dan-sazonov/CanSAD/Лого.jpg

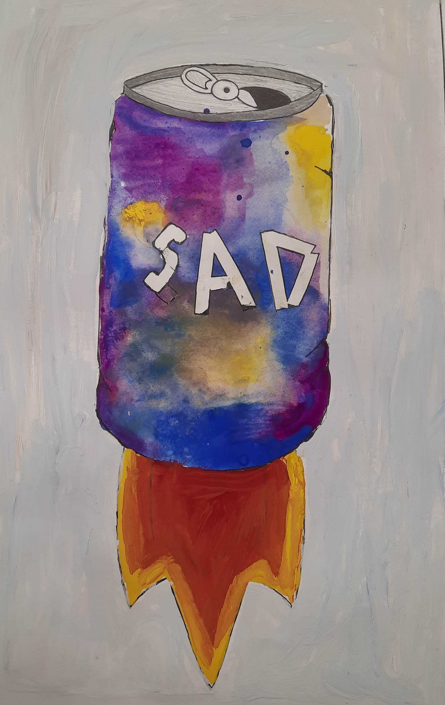
Лого.jpg
