dan-sazonov/CanSAD/Фотки сырые/СС сложенная чертеж.jpg

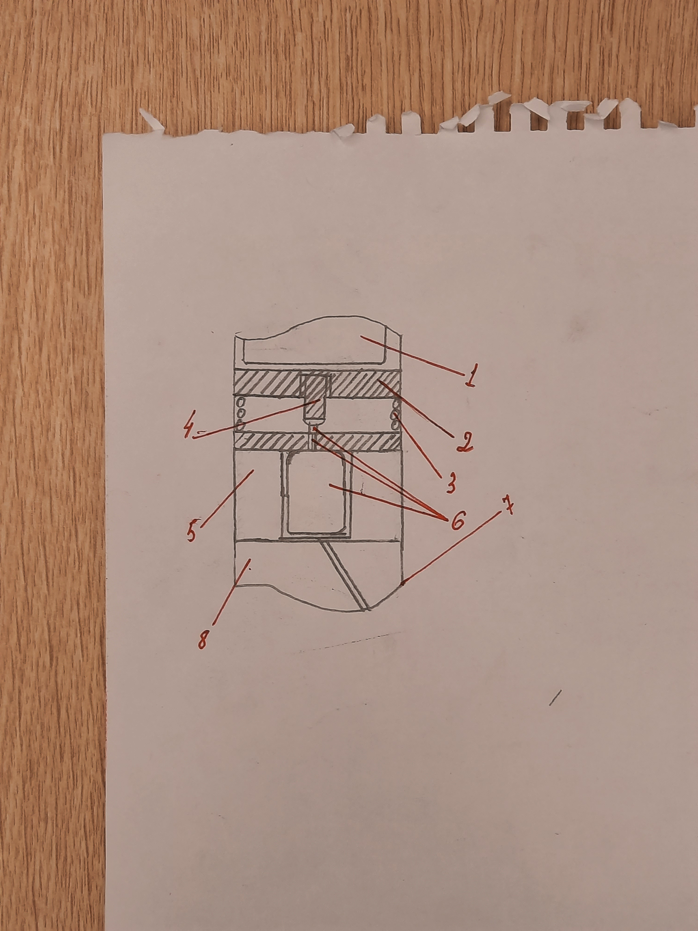
Фотки сырые/СС сложенная чертеж.jpg
