dan-sazonov/CanSAD/README.md

# 🚀CanSAD team
Все рабочие материалы, презентация и пояснительная записка победителей региональных соревнований по спутникостроению "Дежурный по планете".
