dan-sazonov/CanSAD/Доклад.md

# CanSAD

## 1. Обложка
На доске, мы выходим, Дэн приветствует всех

## 2. Состав команды
_Д:_ Наша команда состоит из программиста Даниила Сазонова, 17 лет<br>
_Л:_ и инженера Алексея Аукенова, 14 лет.

## 3. ТЗ
_Л:_  На этом слайде вы видите список задач, которые мы поставили перед собой и решили в ходе работы над данным проектом. При составлении этого списка мы отталкивались от 
информации, представленной в положении юниорской лиги кансата.

## 4. Алгоритм работы спутника
_Д:_ Это блок-схема алгоритма работы системы спасения. После разделения разгонного модуля и отсека полезной нагрузки, которое будет зафиксировано с помощью фоторезистора, микроконтроллер будет ожидать снижения до 110 метров, после чего будет запущен сервопривод, который активирует систему спасения и произойдет выброс парашюта. Значение в 110 метров было выбрано не случайно, на следующих слайдах будет приведено обоснование.

## 5. Фото системы спасения
_Д:_ На этом слайде вы видите фото системы спасения в разложенном виде. Отдельно можно отметить способ прикрепления парашюта. Этот демпфер должен погасить часть энергии во время рывка после открытия купола. К нему через вертлюг прицеплен парашют. Это сделано для того чтобы предотвратить повреждение и запутывания строп.

## 6. Система спасения в сборе
_Л:_ На этом чертеже представлена система спасения полезной нагрузки до срабатывания. Ее принцип работы состоит в том, что за две секунды до достижения высоты в 50 метров сервопривод начинает вращение, и откручивает с вала, на котором закрплен болт, гайку, которая фиксирует пружину с помощью крышки. Чтобы гайка не прокручивалась, было принято решение зафиксировать ее в пропечатанных пазах.

## 7. Система спасения после активации
_Л:_ После того, как гайка слетает с резьбы, пружина освобождается, толкает крышку и она выталкивает сложенный парашют на высоте в 50 метров. Так происходит выброс парашюта, который должен обеспечить плавное приземление отсека с полезной нагрузкой.

## 8. Пружина для системы спасения 
_Л:_ Здесь вы видите чертеж используемой в системе спасения пружины, и все необходимые данные. Исходные значения были измерены нами, все указанные на чертеже значения были получены при помощи онлайн калькулятора на сайте катээс-про

## 9. Расчет времени работы сервопривода
_Д:_ Как известно, сервопривод может поворачиваться только на определенный угол. Для SG90 это 180. Чтобы он мог вращаться сколько угодно, в его конструкцию были внесены некоторые изменения. Таким образом, его вал совершит полный оборот за 0.6 секунды. Чтобы открутить гайку достаточно сделать 3 оборота примерно за 2 секунды, но для предотвращения непредвиденных ситуаций время работы ограничено 5 секундами.

## 10. Расчет высоты активации системы
_Д:_ Чтобы знать на какой высоте нам необходимо активировать систему спасения, нам необходимо знать, на какой высоте будет находится спутник за 2 секунды до высоты в 50 метров. Для этого нам нужно узнать предельно возможную скорость свободного падения. Из 2зн следует, что сила сопротивления свободно падающего тела будет равна его весу. Выразить из этого неравенства скорость и найдём её значение. Важно понимать, что это не реальная скорость снижения, а максимально возможная, те мы берём это значение с довольно большим запасом. Дальше мы умножаем эту скорость на 2 секунды и прибавляет 50 метров, так мы находим высоту активации СС.

## 11. Парашют для СС
_Л:_ На этом слайде вы видите фотографию использанного парашюта, а также формулы для вычисления радиуса парашюта, который фигурирует в дальнейших расчетах. Формула для нахождения площади была взята из пособия Соболева, также как изначения констант. Значения массы спутника и скорости снижения были взяты из регламента соревнований 

## 12. Сегмет парашюта
_Л:_ На данном чертеже мы видим лекало, по которому вырезались сегменты шестисегментного купольного парашюта для спасения отсека с полезной нагрузкой. Данные значения и форма были получены опираясь на схемы и формулы из пособия Соболева, подробнее с ними вы можете ознакомиться в пояснительной записке. 

## 13. Расчет строп парашюта
_Д:_ Здесь представлены расчёты характеристик строп парашюта. Для начала найдем их длину. Согласно материалам из пособия Соболева, длина должна составлять 2.4 радиуса, или 36 см. Теперь найдём максимально возможную силу натяжения строп. Максимальной она будет в момент открытия купола. Подставим в данную формулу известные значения и вычислим силу натяжения. Возможно такое, нагрузка будет неравномерно распределена между шестью стропами, но учитывая что мы брали максимально возможную скорость, уже сделан достаточный запас. 

## 14. Плата спутника
_Л:_ Вот фотография платы нашего спутника. Все ключевые элементы отмечены на схеме, отдельно можно отметить джемперы для переключения вывода юарт. Когда они установлены, и контакты замкнуты, пакеты телеметрии передаются по протоколу юарт на радиомодуль, и он транслирует их по радиоканалу на приемную станцию. Когда они сняты, пакеты идут в монитор порта платы.

## 15. Структурная схема спутника
_Д:_ Это блок-схема электроники полезной нагрузки. Акселерометр, датчик давления, магнитометр и температурный датчик, которые представлены модулем GY801, подключаются к микроконтроллеру по протоколу I2C. Модуль SD карты использует интерфейс SPI, приемопередатчик – UART. Источником питания является литий-полимерный аккумулятор с напряжением 7,4В, который подключается к Arduino Nano. Остальные элементы, отраженные на приведенной ниже блок-схеме, питаются напряжением +5В, которое снимается со встроенного в Arduino Nano линейного стабилизатора.

## 16. Принципиальная электрическая схема
_Д:_ На этом слайде вы видите принципиальную схему полезной нагрузки. Для получения, обработки и передачи информации между модулями спутника используется мк ардуино нано на чипе атмега 328. Для отправки телеметрии на приемную станцию по радиоканалу на частоте 433 мегагерца используется приемопередатчик sv610. Также все данные записываются на эсдэ карту. Для измерения параметров среды используется модуль GY801. Для измерения напряжения аккумулятора используется резистивный делитель напряжения с коэффициентом деления 2. Пониженное напряжение подается на контакт A7. Для ограничения тока питания приемопередатчика SV610 используется транзистор VT2. Через транзистор VT1 подается напряжение на сервопривод системы спасения. 

## 17. Алгоритм работы спутника
_Л:_ На этом слайде представлена блок-схема алгоритма работы програмного кода полезной нагрузки. Микроконтроллер анализирует данные, полученные со всех датчиков. Выполняя расчеты, микроконтроллер фиксирует точки старта, апогея, посадки, разделения полезной нагрузки и разгонного модуля, запускает в нужный момент систему спасения и сохраняет и передает телеметрию. Технические моменты более подробно описаны в пояснительной записке и на слайде. 

## 18. Расчет энергопотребления
_Л:_ Здесь вы видите таблицу, в которой представлена информация о энергопотреблении всех элементов схемы. Мы рассматривали пиковые значения тока поребления. Также мы сделали запас и рассчитали ток потребления для одновременно восьми работающих светодиодов на протяжении всего времени полета, хотя в реальности такое не возможно.

ШОУ ИМПРОВИЗАЦИЯ
