dan-sazonov/CanSAD/Чертежи сырцы/СС общий вид.pdf

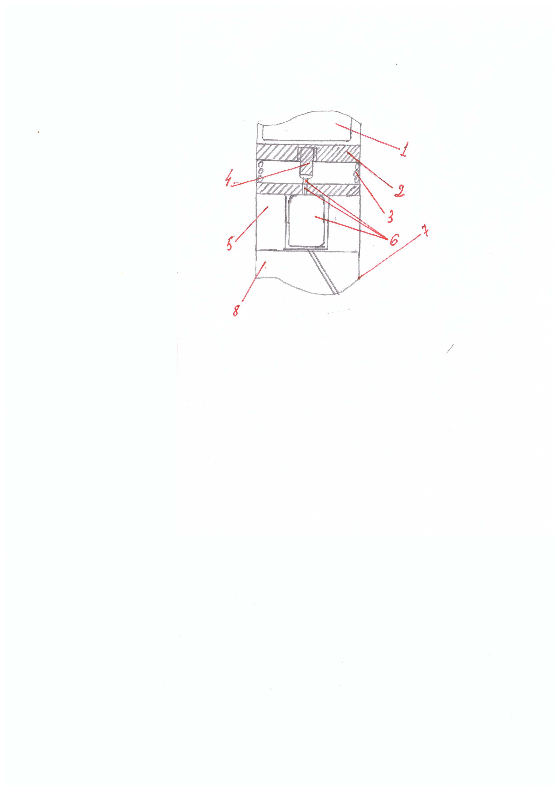
[picture p49: page 1]
