dan-sazonov/CanSAD/Чертежи сырцы/СС открытая.pdf

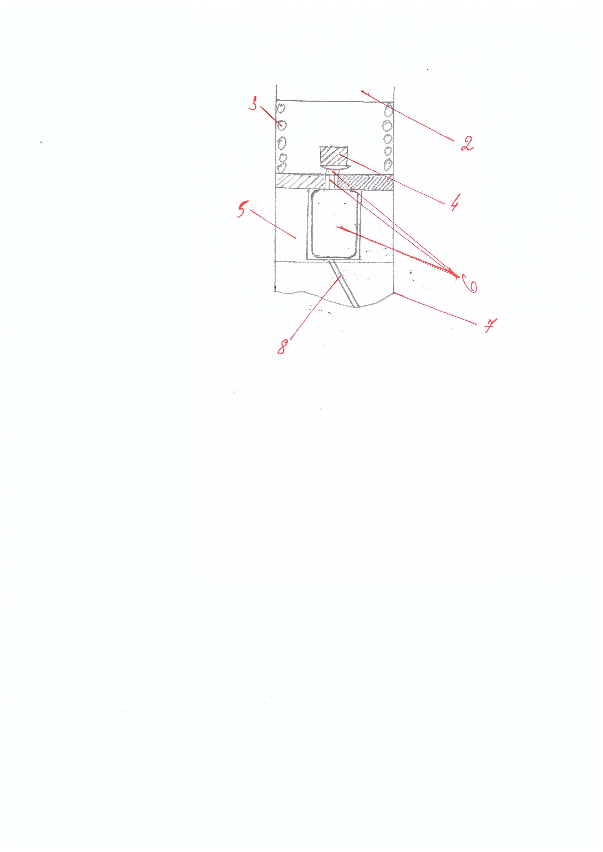
[picture p50: page 1]
