dan-sazonov/CanSAD/Фотки наши/Даня.jpg

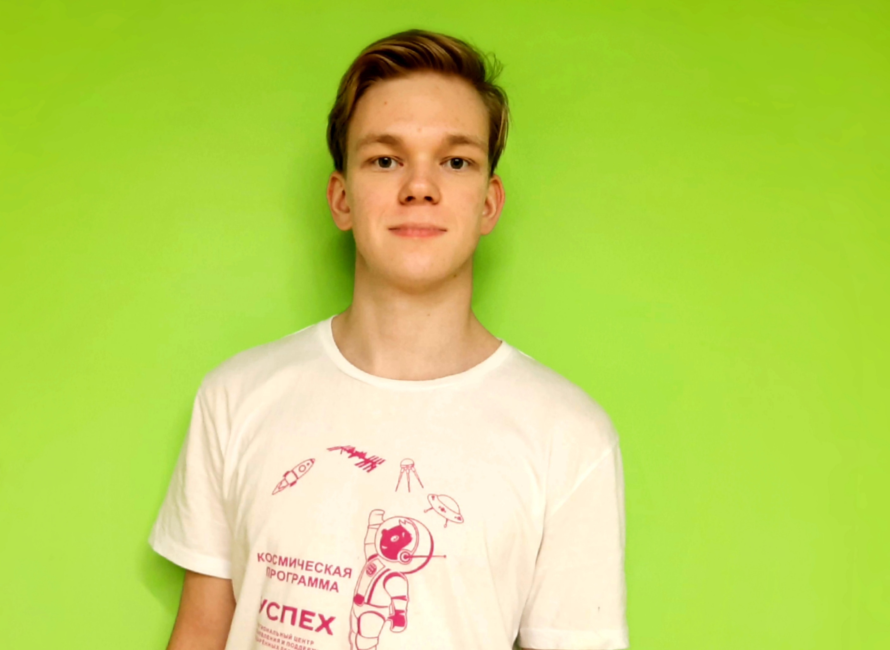
Фотки наши/Даня.jpg
