dan-sazonov/CanSAD/Фотки наши/Леха.jpg

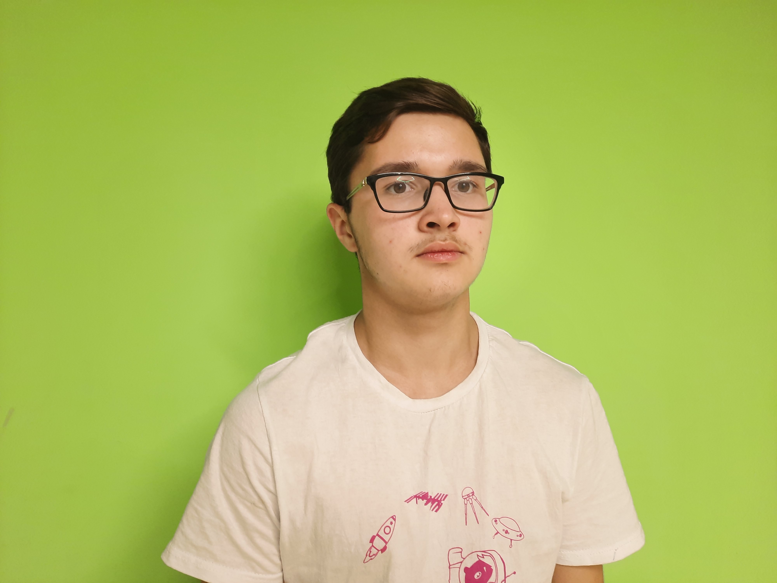
Фотки наши/Леха.jpg
