dan-sazonov/CanSAD/Фотки преза/Cерва фотка.jpg

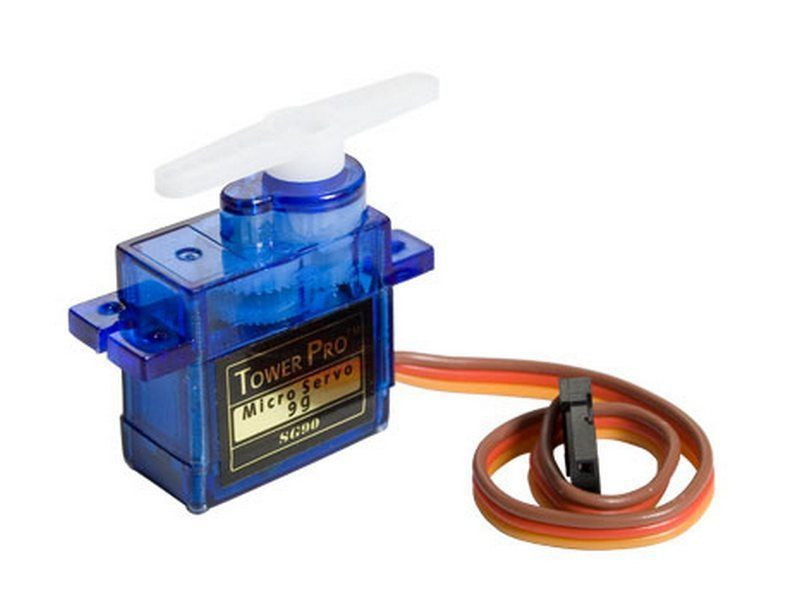
Фотки преза/Cерва фотка.jpg
