dan-sazonov/CanSAD/Фотки преза/Парашют.jpg

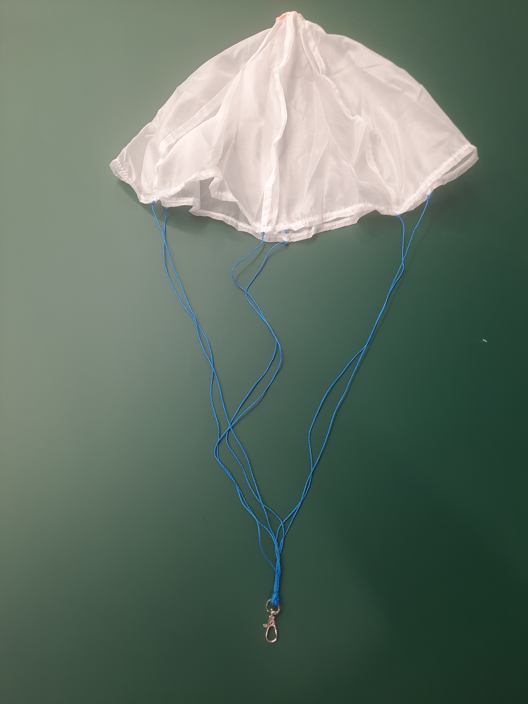
Фотки преза/Парашют.jpg
