dan-sazonov/CanSAD/Фотки преза/Спутник фотка.jpg

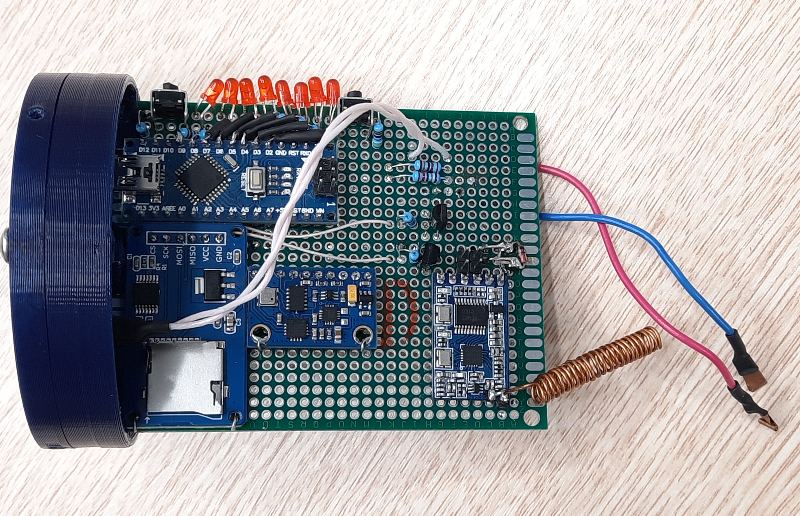
Фотки преза/Спутник фотка.jpg
