dan-sazonov/CanSAD/Фотки преза/СС общий вид.jpg

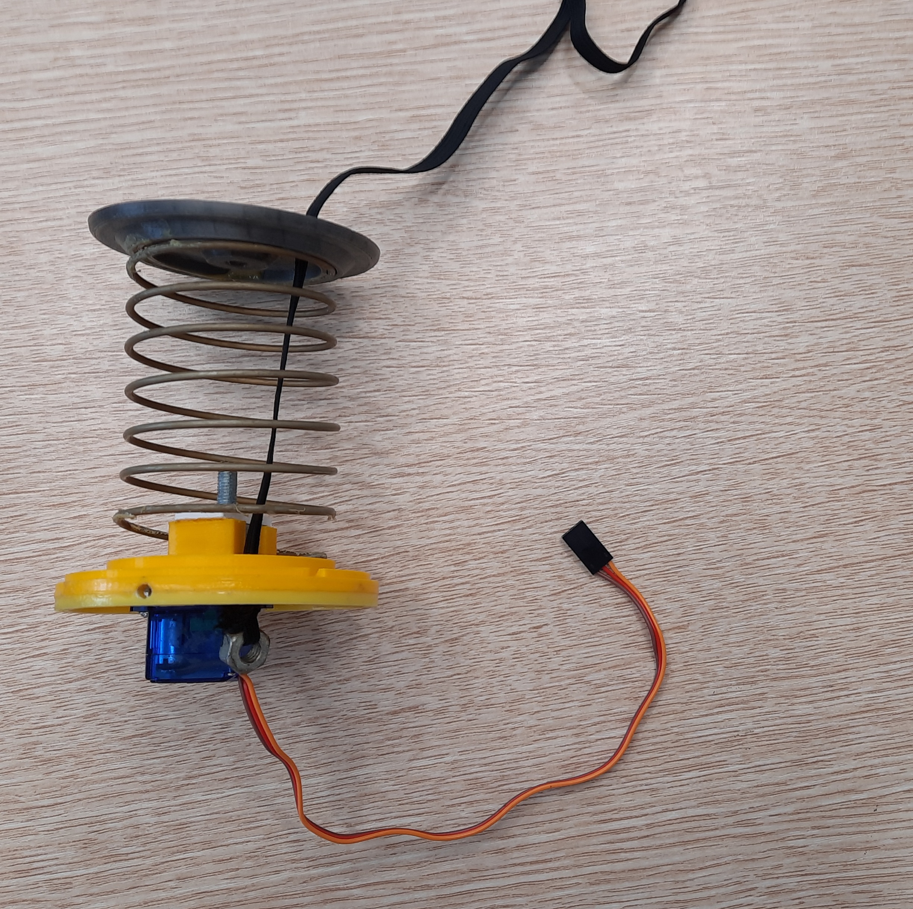
Фотки преза/СС общий вид.jpg
