dan-sazonov/CanSAD/Фотки сырые/СС общий вид чертеж.jpg

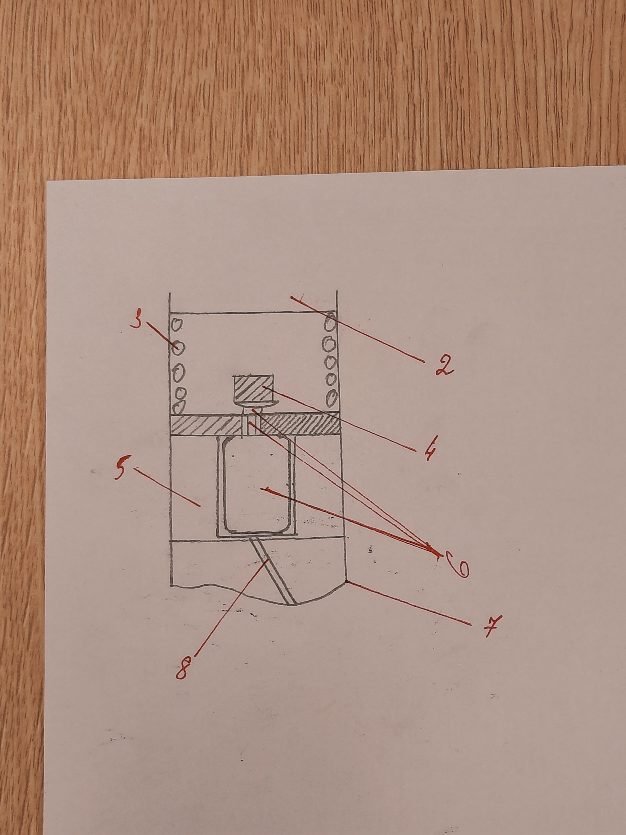
Фотки сырые/СС общий вид чертеж.jpg
