dan-sazonov/CanSAD/Фотки сырые/СС общий вид.jpg

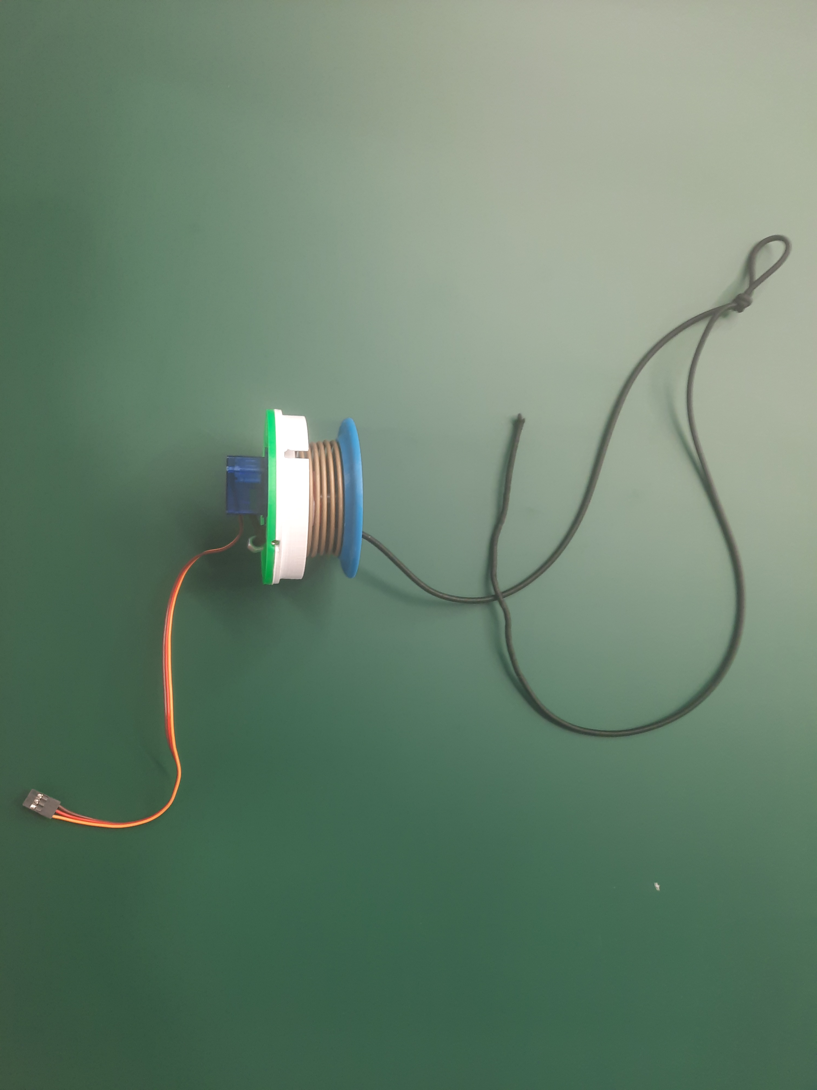
Фотки сырые/СС общий вид.jpg
