dan-sazonov/CanSAD/Фотки сырые/СС сложенная 2.jpg

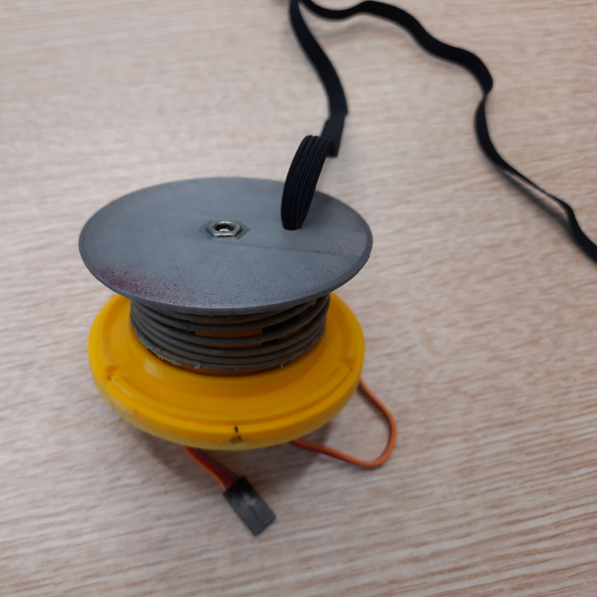
Фотки сырые/СС сложенная 2.jpg
