dan-sazonov/CanSAD/Фотки сырые/СС сложенная.jpg

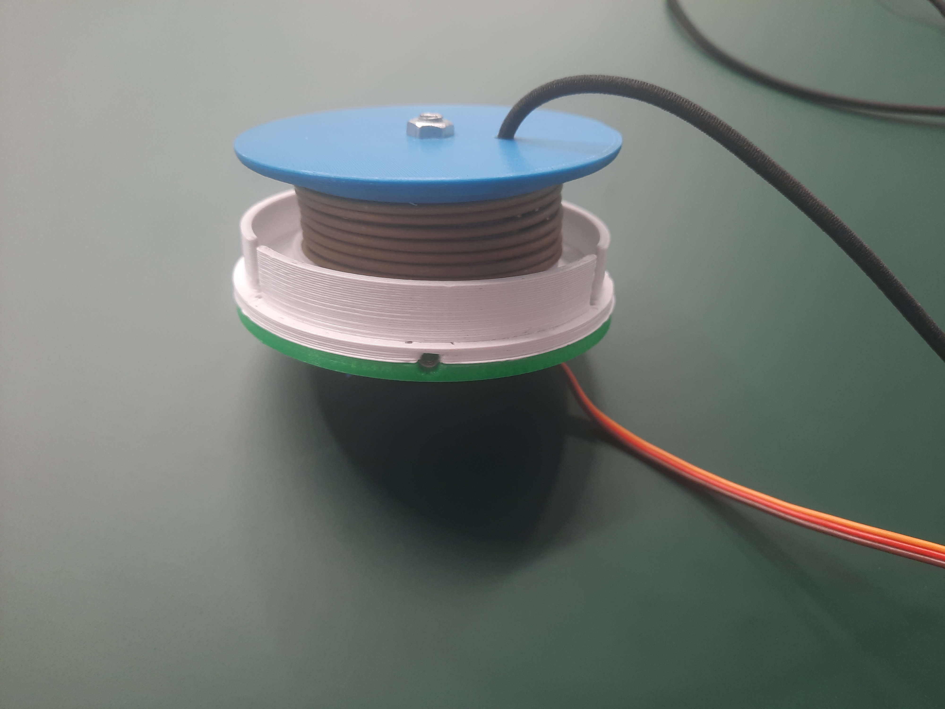
Фотки сырые/СС сложенная.jpg
