dan-sazonov/CanSAD/Чертежи сырцы/openrocket расчет.png

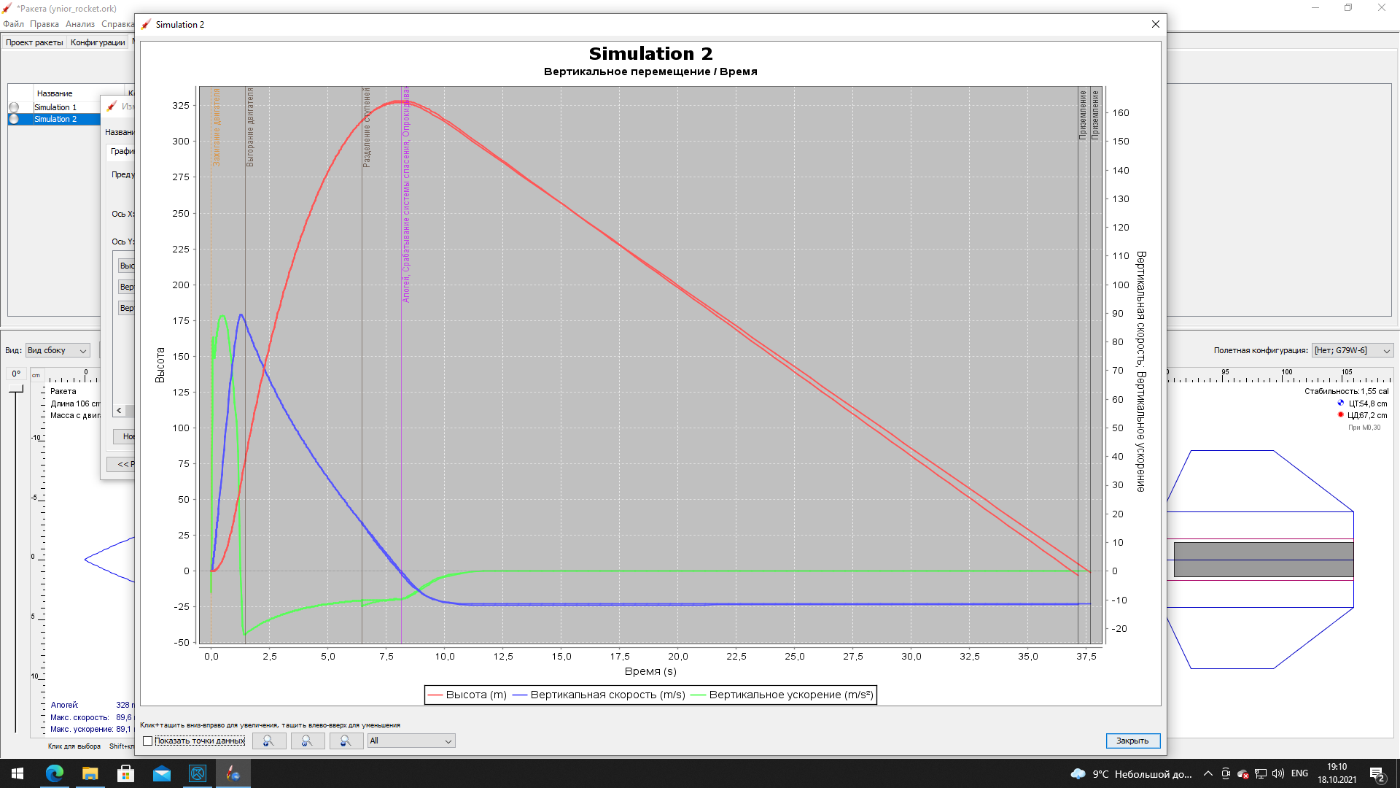
Чертежи сырцы/openrocket расчет.png
