dan-sazonov/CanSAD/Чертежи экспорт/openrocket расчет.png

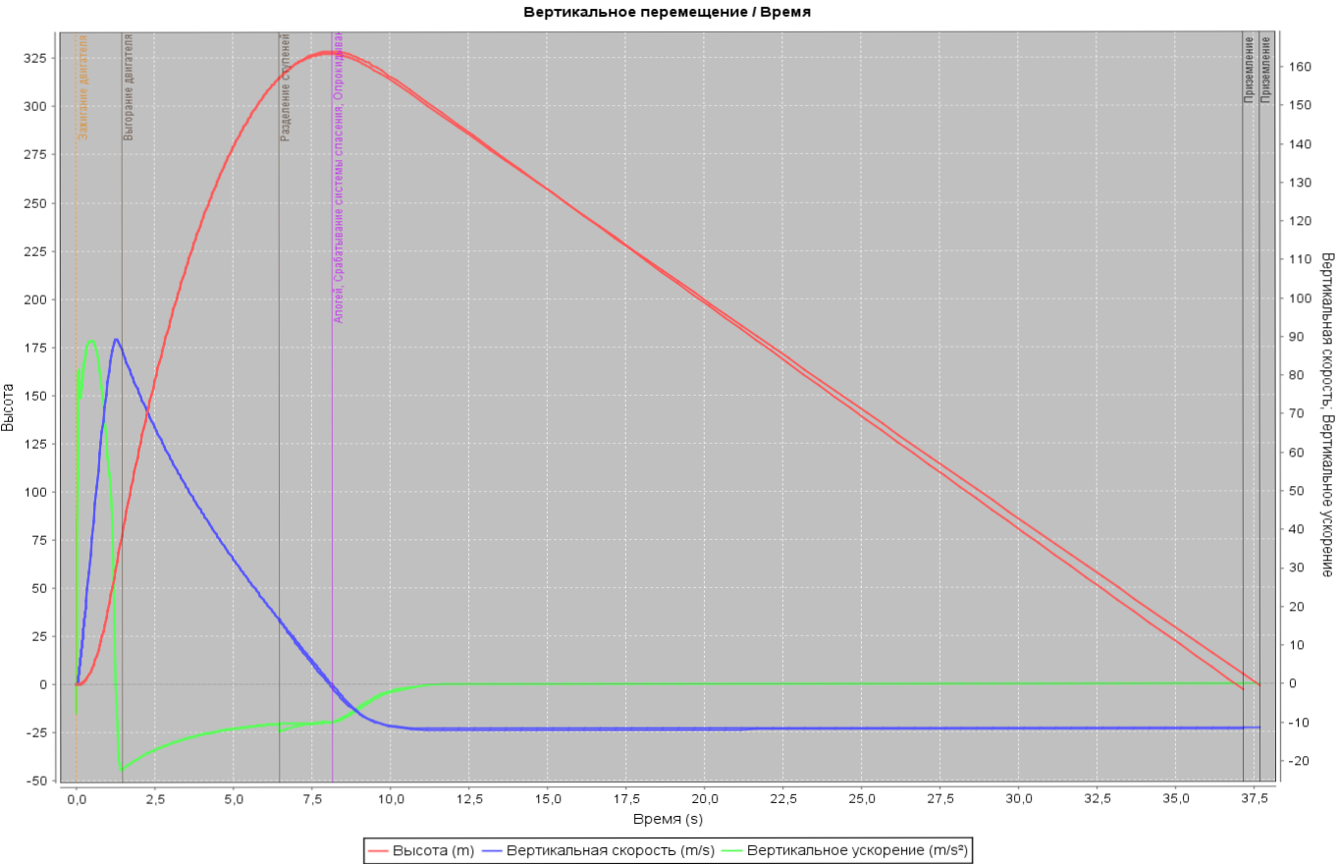
Чертежи экспорт/openrocket расчет.png
