dan-sazonov/CanSAD/Чертежи экспорт/Алгоритм работы спутника.drawio.png

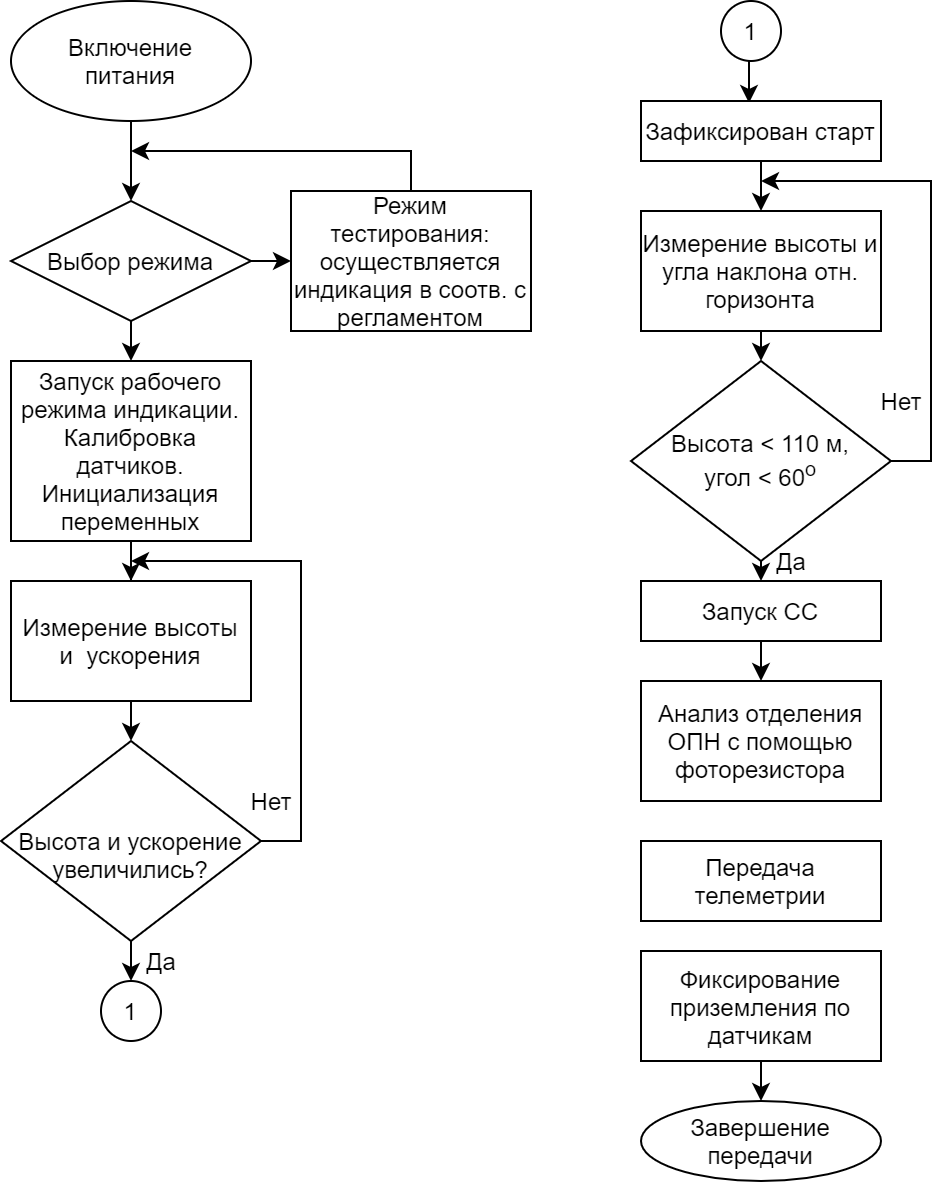
Чертежи экспорт/Алгоритм работы спутника.drawio.png
