dan-sazonov/CanSAD/Чертежи экспорт/Пружина.png

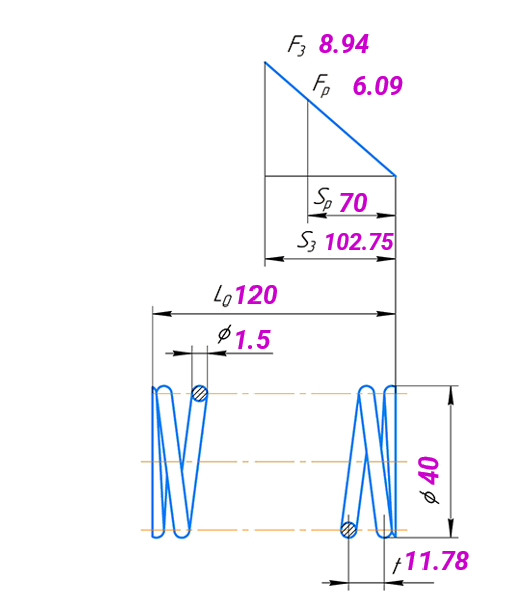
Чертежи экспорт/Пружина.png
