dan-sazonov/CanSAD/Чертежи экспорт/СС общий вид.png

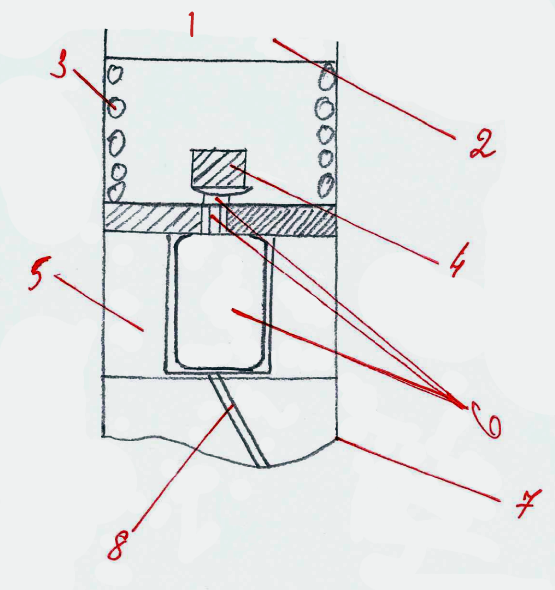
Чертежи экспорт/СС общий вид.png
