dan-sazonov/CanSAD/Чертежи экспорт/СС сложенная.png

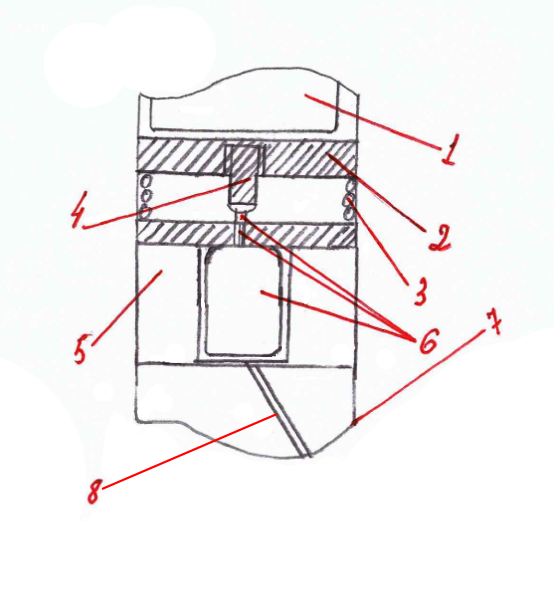
Чертежи экспорт/СС сложенная.png
