dan-sazonov/CanSAD/(list of files, drawings)

Other design files:
Чертежи сырцы/Электроника ПЭС EasyEDA.json
