dan-sazonov/CanSAD/(commit log)

2021-10-18 Добавил график опенрокета
2021-10-18 Добавил чертеж стабилизатора
2021-10-18 Добавил проект Компаса
2021-10-19 Скачал либу для l3g
2021-10-19 Создал скетч с примером для l3g
2021-10-19 Скачал либу для ADXL345
2021-10-19 Докинул в скетч примеры для adxl
2021-10-19 Скачал либу для hmc
2021-10-19 Скачал либу для bmp
2021-10-19 Скинул либы в один каталог
2021-10-19 Докачал либу для сенсоров
2021-10-19 Запилил по примерам высотомер
2021-10-19 Написал высотомер
2021-10-19 Запрогал флаги для телеметрии
2021-10-19 Начал писать таймер для рекавери
2021-10-20 Скинул старый чертеж
2021-10-20 Докинул наши фотки
2021-10-20 Докинул фотки для презы
2021-10-20 Создал новые папки, скинул чертеж сегмента
2021-10-20 Скинул чертеж сегмента
2021-10-20 Скинул графики из опенрокет
2021-10-20 Скинул учебник Соболева
2021-10-20 Скинул чертеж пружины
2021-10-20 Начал делать новую презентацию
2021-10-20 Добавил слайд с фотками
2021-10-21 Переписал ТЗ, поправил дезигн
2021-10-21 Отметил слайды, которые надо переделать
2021-10-21 Сделал слайд про парашют
2021-10-21 Поправил код, добавил комменты
2021-10-21 Написал таймер для сервы
2021-10-21 Запилил флаг приземления
2021-10-21 Настроил интервалы отправки телеметрии
2021-10-21 Сделал слайд про сегмент парашюта
2021-10-21 Скинул сырые фотки и сделал слайд с пружиной
2021-10-21 Добавил основную ПЭС
2021-10-21 Сделал слайд с ПЭС
2021-10-21 Пофиксил ПЭС
    [Электроника ПЭС EasyEDA.json]
2021-10-21 Добавил в презу чертежи СС
2021-10-21 Переписал инфу про тиму и ТЗ
2021-10-21 Докинул фотки, поправил презу
2021-10-21 Сделал все расчёты для сервы
2021-10-22 Вынес инфу про стропы на отдельный слайд
2021-10-22 Запилил алгоритм работы спутника
2021-10-22 Сделал структурную схему спутника
2021-10-22 Добавил фотку спутника
2021-10-22 Добавил таблицу с рассчетом потребления
2021-10-22 Сделал последний слайд
2021-10-22 Добавил расчеты из openrocket
2021-10-22 Поправил презу
2021-10-22 Расчитал силу натяжения строп
2021-10-22 Пофиксил структурную схему
2021-10-22 Скинул пример телеметрии
    [ПРИМЕР.xlsx]
2021-10-22 Поправмл орфографию
2021-10-22 Написал план, раскидал роли
2021-10-22 Поправил что-то
2021-10-22 Написал лехин текст
2021-10-22 Поменял фигню
2021-10-22 Поправил стрелки насхеме
2021-10-22 Начал писать свой текст
2021-10-22 Дописал кое-как свои слова
2021-10-23 Скинул телеметрию с sd
2021-10-23 Распарсил телеметрию с SD
    [SD-parsed.xlsx]
2021-10-23 Скинул акталььные данные в новый файл
    [SD-actual.xlsx, SD-parsed.xlsx]
2021-10-23 Скинул телеметрию с земли
2021-10-23 Поправил актуальные данные
    [SD-actual.xlsx]
2021-10-23 Распарсил телеметрию с земли
    [Земля-parsed.xlsx, Земля.xlsx]
2021-10-23 Поправил время
    [SD-actual.xlsx, Земля-parsed.xlsx]
2021-10-23 Построил график высоты
    [SD-actual.xlsx]
2021-10-23 Выпилил график высоты, построил график давления
    [SD-actual.xlsx]
2021-10-23 Переделал высоту
    [SD-actual.xlsx]
2021-10-23 Построил температуру
    [SD-actual.xlsx]
2021-10-23 Построил модуль ускорения
    [SD-actual.xlsx]
2021-10-23 Построил проекции ускорений
    [SD-actual.xlsx]
2021-10-23 Переделал модуль ускорения
    [SD-actual.xlsx]
2021-10-23 Построил магнитное поле
    [SD-actual.xlsx]
2021-10-23 Закинул графики в презу
    [SD-actual.xlsx]
2021-10-23 Скинул старую ПЗ
2021-10-23 Начал переписывать Пз
2021-10-23 Последние фиксы
    [SD-actual.xlsx]
2021-10-24 Последние правки
